RochaLabND/SoilTemperatureLogger/parts/substitute_parts.csv

Some component within the data logger have recently been discontinued or are difficult to get. This list details any suggested substitutions.
Original component | Original link | New component | New link | Notes
Pololu 5V Step-Up Voltage Regulator U1V11F5 | https://www.pololu.com/product/2562 | Pololu Adjustable Step-Up Voltage Regulator U1V11A | https://www.pololu.com/product/2560 | The replacement regulator uses the same circuit board more or less you need to remove the same component mentioned in the instructions then apply power to the regulator, measure the output voltage and move the screw on the top until it gives you 5 volts across the output.
Memory Socket 2041021-3 (TE connectivity) | https://canada.newark.com/te-connectivity/2041021-3/memory-card-connector-sd-9-position/dp/35R2925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 | Memory Socket GSD090012SEU (Amphenol ICC) | https://www.digikey.ca/en/products/detail/amphenol-cs-commercial-products/GSD090012SEU/13683164 | This is a drop in replacement with the same footprint on the PCB
