RochaLabND/SoilTemperatureLogger/parts/all_tools_and_parts.xlsx

TOOLS |  |  |  |  | CIRCUIT BOARD
Tool Type | Qty (#) | Approx. Price (USD $) | Description | Suggested | Parameter | Value
Mechanical | 1 | 75 | Soldering Iron |  | Base material | FR-4 TG130 (or other low cost epoxy laminate)
Mechanical | 1 | 15 | 60/40 Tin-Lead Solder with 1.8% Flux and 0.6mm dia |  | Number of layers | 2 layers
Mechanical | 1 | 11.95 | Precision Flat Pliers | https://www.adafruit.com/product/1368 | PCB dimensions | 100mm x 50mm
Mechanical | 1 | 7.25 | Flush Diagonal Cutters | https://www.adafruit.com/product/152 | PCB quantity | User determined
Mechanical | 1 | 34.95 | Ratcheted Crimper Pliers | https://www.adafruit.com/product/1213 | Number of different designs | 1
Programmer | 1 | 27.5 | PICKit3 Micropchip Programmer with ICSP Socket |  | PCB thickness | 1.60 (or other default/inexpensive value)
Programmer | 1 | 17 | AVR ISP Programmer Shield (Burn Bootloader Programmer) | https://www.diymore.cc/products/avr-isp-shield-burning-burn-bootloader-programmer-for-arduino-uno-r3 | PCB color | Green (or other default/inexpensive value)
Programmer | 1 | 23 | Arduino Uno | https://store.arduino.cc/usa/arduino-uno-rev3 | Surface finish | HASL
Programmer | 1 | 14.75 | FTDI Friend | https://www.adafruit.com/product/284 | Maximum solder mask dam | 0.4mm
 |  |  |  |  | Copper weight | 1oz
COMPONENTS |  |  |  |  | Minimum drill hole size | 0.3mm
 |  |  |  |  | Trace width / spacing | 6/6 mil
Placement | Qty (#) | Approx. Price ($) | Description | Digi-Key Part Number | Blind or buried vias | No
IC4 | 1 | 0.4 | IC BUS BUFFER TRI-ST QD 14DIP | 296-4531-5-ND | Plated half-holes/castellated holes | No
IC1 | 1 | 0.33 | CONN IC DIP SOCKET 28POS TIN | ED3050-5-ND | Impedance control | No
IC2, IC3 | 1 | 0.16 | CONN IC DIP SOCKET 8POS TIN | ED3044-5-ND | PCB assembly | Leave option unselected
 | 3 | 0.37 | 10POS SIL VERTICAL PIN HEADER | 952-1843-ND | SMT stencil | Leave option unselected
IC5 | 1 | 0.38 | IC REG LDO 3.3V 0.25A TO92-3 | MCP1700-3302E/TO-ND
 | 1 | 1.22 | IC MCU 8BIT 3.5KB FLASH 8DIP | PIC12F683-I/P-ND | EXTERNAL HOUSING
 | 1 | 2.14 | IC MCU 8BIT 32KB FLASH 28DIP | ATMEGA328P-PU-ND
L1, L3 | 2 | 0.55 | LED RED DIFF 5MM ROUND T/H | 754-1275-ND | ID | Description | URL
L2 | 1 | 0.48 | LED GRN DIFF 5MM ROUND T/H | 754-1735-ND | 1 | Flexible cap | NA
220 | 3 | 0.1 | RES 220 OHM 1/4W 5% AXIAL | 220QBK-ND | 2 | 4 inch schedule 40 PVC pipe | NA
.1uf | 5 | 0.22 | CAP CER 0.1UF 50V X7R RADIAL | 399-4264-ND | 3 | Flat PVC cap | NA
2k | 1 | 0.1 | RES 2K OHM 1/4W 5% AXIAL | 2.0KQBK-ND | 4 | 4 port cable gland | https://www.mcmaster.com/7807k39
10k | 6 | 0.1 | RES 10K OHM 1/4W 5% AXIAL | 10KQBK-ND | NA | PVC primer and solvent cement | NA
 | 1 | 1.28 | HOLDER BATT 2-AA CELLS WIRE LDS | BC22AAW-ND | NA | 1/2"-14 NPT Pipe Tap | NA
22pf | 2 | 0.3 | CAP CER 22PF 200V C0G/NP0 RADIAL | 399-13930-1-ND | NA | 45/64 in drill bit | NA
 | 4 | 0.17 | SIL FEMALE CRIMP HOUSING 3POS | 952-2228-ND
 | 12 | 0.1 | FEMALE CRIMP CONTACT SELECTIVE | 952-2157-1-ND
B1 (lower) | 1 | 0.75 | SWITCH TACTILE SPST-NO 0.01A 32V | 401-1812-ND
 | 1 | 4.19 | IC RTC CLK/CALENDAR I2C 8-DIP | DS1307N+-ND
Y2 | 1 | 0.17 | CRYSTAL 32.7680KHZ 12.5PF T/H | 535-9034-ND
 | 1 | 0.7 | BATTERY LITHIUM 3V COIN 12.5MM | SY033-ND
 | 1 | 0.35 | SIL HORIZ PC TAIL PIN HEADER | 952-2247-ND
B1 (upper) | 1 | 1.14 | HOLDER COIN CELL FOR CR1220 SMD | BC501SM-ND
DS18B20 | 1 | 3.06 | SENSOR TEMPERATURE 1-WIRE TO92-3 | DS18B20+-ND
4.7k | 1 | 0.1 | RES 4.7K OHM 1/4W 5% AXIAL | 4.7KQBK-ND
Y1 | 1 | 0.38 | CRYSTAL 16.0000MHZ 20PF T/H | CTX415-ND
 | 1 | 4.95 | Pololu 5V Step-Up Voltage Regulator U1V11F5 | NA
SD1 | 1 | 2.44 | Memory Socket, Memory Card, 9 Contacts, Phosphor Bronze, Gold Plated Contacts | NA
 | 1 | 3.75 | 8 - 16GB SD card | NA
 | 4 | 1.8 | DS18B20 Temperature Sensor with Stainless Steel Package | NA
 | 1 | 1.49 | Printed circuit boards | NA
 |  | 33.67
