RochaLabND/SoilTemperatureLogger/CAD_files/logger_thruhole_2.brd

## EAGLE design CAD_files/logger_thruhole_2.brd (2021-11-12)

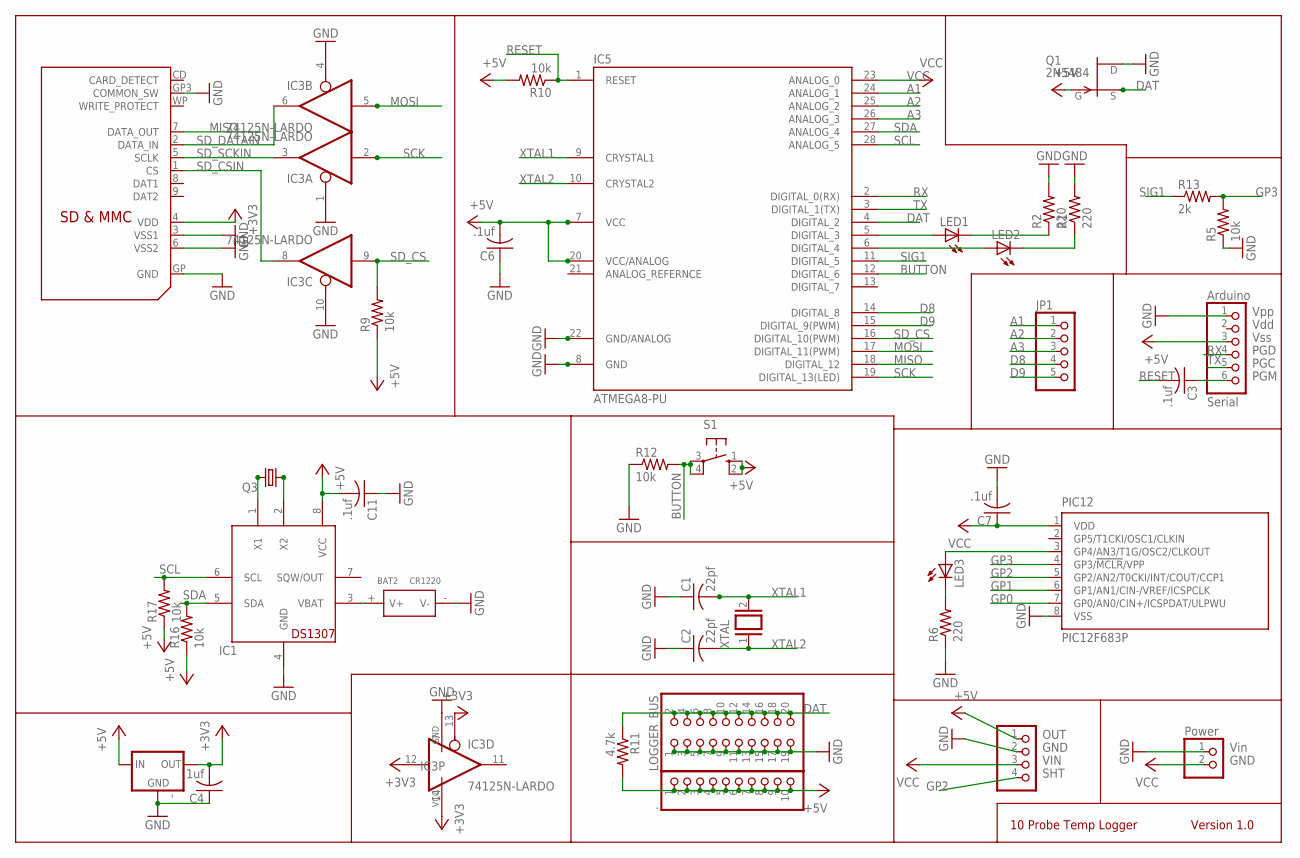
[picture p1: schematic logger_thruhole_2.sch]

Parts:
': MCP1700TRI; TO92
.: PINHD-1X10; 1X10
BAT2: CR1220; BAT2P-SMD-16.4-CR1220
C1, C2: 22pf; C025-025X050
C3, C4, C6, C7, C11: .1uf; C025-025X050
IC1: DS1307; DIL08
IC3: 74125N-LARDO; DIL14-LARDO
IC5: ATMEGA8-PU; DIL28-3
JP1: PINHD-1X5; 1X05
JP2: PINHD-1X6; 1X06
LED1, LED2, LED3: LEDLZR181; LZR181
LOGGER_BUS: PINHD-2X10; 2X10
PIC12: PIC12F683P; DIL8
POWER: PINHD-1X2; 1X02
Q1: 2N5484; TO92-
Q3: CRYSTALTC38H; TC38H
R1, R2, R6: 220; 0207/2V
R5, R9, R10, R12, R16, R17: 10k; 0207/2V
R11: 4.7k; 0207/2V
R13: 2k; 0207/2V
REG: PINHD-1X4; 1X04
S1: 10-XX; B3F-10XX
U$2: SDMMC06132; 06132
XTAL: XTAL/S; QS

Connections:
+3V3: '.3 (OUT), C4.2, IC3.12 (I), IC3.13 (OE), IC3.14 (VCC), U$2.4 (VDD)
+5V: '.2 (IN), ..1, ..2, ..3, ..4, ..5, ..6, ..7, ..8, ..9, ..10, C6.2, C11.2, IC1.8 (VCC), IC5.7 (VCC), IC5.20 (VCC/ANALOG), JP2.3, Q1.1 (G), R9.1, R10.2, R11.2, R16.1, R17.1, REG.1, S1.1 (S), S1.2 (S1)
A1: IC5.24 (ANALOG_1), JP1.1
A2: IC5.25 (ANALOG_2), JP1.2
A3: IC5.26 (ANALOG_3), JP1.3
BUTTON: IC5.12 (DIGITAL_6), R12.2, S1.3, S1.4 (P1)
D8: IC5.14 (DIGITAL_8), JP1.4
D9: IC5.15 (DIGITAL_9(PWM)), JP1.5
DAT: IC5.4 (DIGITAL_2), LOGGER_BUS.2, LOGGER_BUS.4, LOGGER_BUS.6, LOGGER_BUS.8, LOGGER_BUS.10, LOGGER_BUS.12, LOGGER_BUS.14, LOGGER_BUS.16, LOGGER_BUS.18, LOGGER_BUS.20, Q1.2 (S), R11.1
GND: '.1 (GND), BAT2.- (V-), C1.1, C2.1, C4.1, C6.1, C7.2, C11.1, IC1.4 (GND), IC3.1 (OE), IC3.4 (OE), IC3.7 (GND), IC3.10 (OE), IC5.8 (GND), IC5.22 (GND/ANALOG), JP2.1, LOGGER_BUS.1, LOGGER_BUS.3, LOGGER_BUS.5, LOGGER_BUS.7, LOGGER_BUS.9, LOGGER_BUS.11, LOGGER_BUS.13, LOGGER_BUS.15, LOGGER_BUS.17, LOGGER_BUS.19, PIC12.8 (VSS), POWER.1, Q1.3 (D), R1.2, R2.2, R5.1, R6.1, R12.1, REG.2, U$2.3 (VSS1), U$2.6 (VSS2), U$2.GP (GND), U$2.GP3 (COMMON_SW)
GP0: PIC12.7 (GP0/AN0/CIN+/ICSPDAT/ULPWU)
GP1: PIC12.6 (GP1/AN1/CIN-/VREF/ICSPCLK)
GP2: PIC12.5 (GP2/AN2/T0CKI/INT/COUT/CCP1), REG.4
GP3: PIC12.4 (GP3/!MCLR!/VPP), R5.2, R13.2
MISO: IC5.18 (DIGITAL_12), U$2.7 (DATA_OUT)
MOSI: IC3.5 (I), IC5.17 (DIGITAL_11(PWM))
unnamed: IC5.5 (DIGITAL_3), LED1.A
unnamed: BAT2.+ (V+), IC1.3 (VBAT)
unnamed: IC5.6 (DIGITAL_4), LED2.A
unnamed: LED3.A, PIC12.3 (GP4/AN3/T1G/OSC2/CLKOUT)
unnamed: IC1.1 (X1), Q3.2
unnamed: LED1.K (C), R2.1
unnamed: IC1.2 (X2), Q3.1
unnamed: LED2.K (C), R1.1
unnamed: LED3.K (C), R6.2
unnamed: C3.1, JP2.6
RESET: C3.2, IC5.1 (RESET), R10.1
RX: IC5.2 (DIGITAL_0(RX)), JP2.4
SCK: IC3.2 (I), IC5.19 (DIGITAL_13(LED))
SCL: IC1.6 (SCL), IC5.28 (ANALOG_5), R17.2
SDA: IC1.5 (SDA), IC5.27 (ANALOG_4), R16.2
SD_CS: IC3.9 (I), IC5.16 (DIGITAL_10(PWM)), R9.2
SD_CSIN: IC3.8 (O), U$2.1 (CS)
SD_DATAIN: IC3.6 (O), U$2.2 (DATA_IN)
SD_SCKIN: IC3.3 (O), U$2.5 (SCLK)
SIG1: IC5.11 (DIGITAL_5), R13.1
TX: IC5.3 (DIGITAL_1(TX)), JP2.5
VCC: C7.1, IC5.23 (ANALOG_0), PIC12.1 (VDD), POWER.2, REG.3
XTAL1: C1.2, IC5.9 (CRYSTAL1), XTAL.2
XTAL2: C2.2, IC5.10 (CRYSTAL2), XTAL.1

Notes on the sheet:
10 Probe Temp Logger
Version 1.0

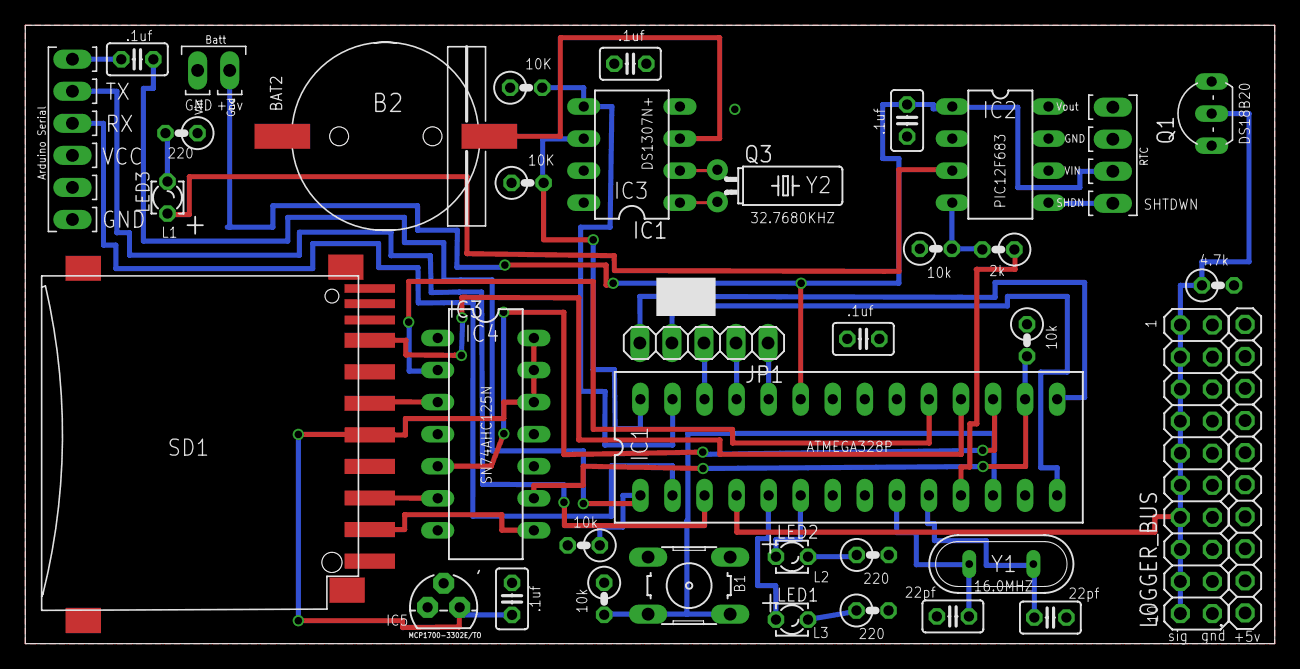
[picture p2: board logger_thruhole_2.brd from above]

Board: 2 copper layers, 99.0 x 49.0 mm, 38 parts (0 on the bottom side), 38 nets.
