RochaLabND/SoilTemperatureLogger/(commit log)

2021-10-21 Add files via upload
    Added a sample of soil temperature data collected in the field using the DIY soil temperature logger.
    -Ian
2021-11-12 Added CAD_files
    [logger_thruhole_2.brd, logger_thruhole_2.sch]
2023-01-12 added a list of substitute parts
    [substitute_parts.csv]
